t-leongchuan/r2auto_nav_CDE2310_grp4/docs/stl_files/Launcher Base.stl

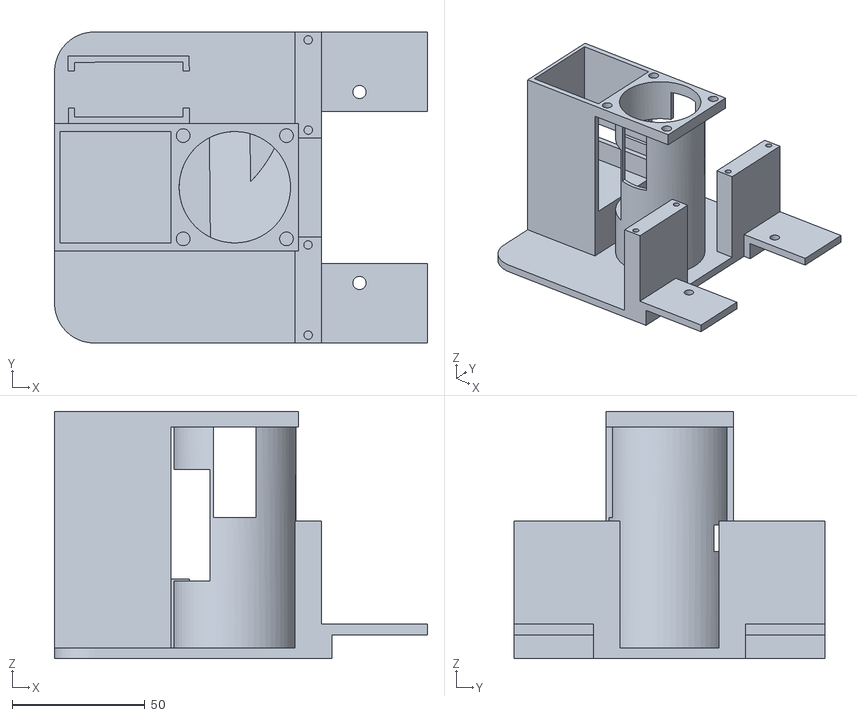
[picture p3: CAD file, 2025-04-23]
docs/stl_files/Launcher Base.stl
140.6 x 117.3 x 93.3
