t-leongchuan/r2auto_nav_CDE2310_grp4/docs/stl_files/Servo Adapter.stl

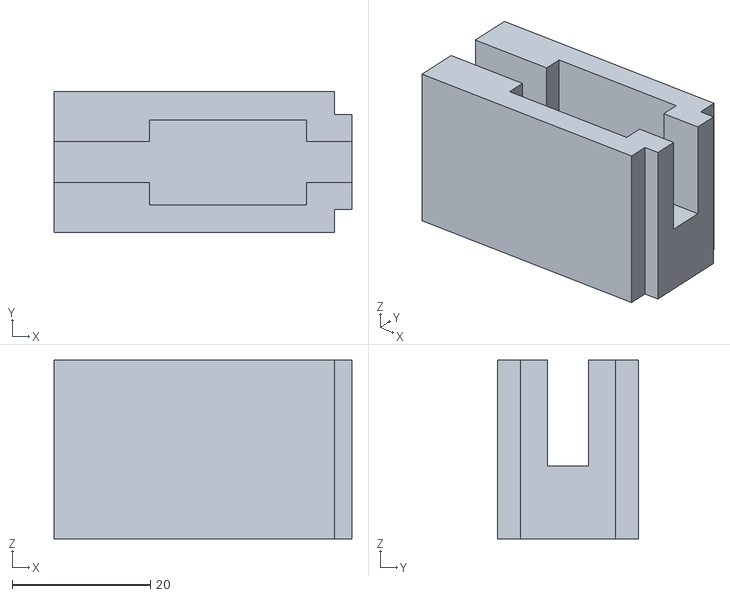
[picture p4: CAD file, 2025-04-23]
docs/stl_files/Servo Adapter.stl
43.1 x 20.4 x 25.9
