t-leongchuan/r2auto_nav_CDE2310_grp4/docs/stl_files/Motor Holder.stl

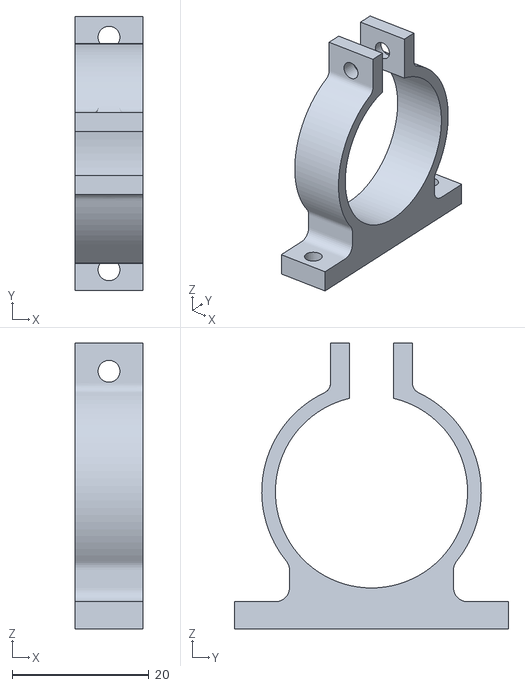
[picture p5: CAD file, 2025-04-23]
docs/stl_files/Motor Holder.stl
10.0 x 40.0 x 41.8
