t-leongchuan/r2auto_nav_CDE2310_grp4/docs/stl_files/AMG8833 Holder.stl

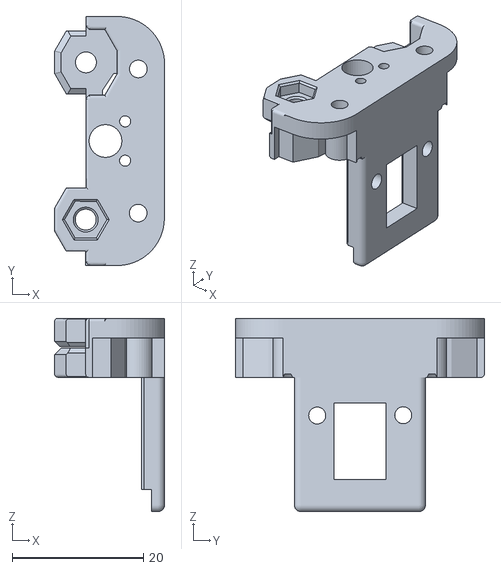
[picture p6: CAD file, 2025-04-23]
docs/stl_files/AMG8833 Holder.stl
16.8 x 38.0 x 29.5
