t-leongchuan/r2auto_nav_CDE2310_grp4/docs/stl_files/L298N Holder.stl

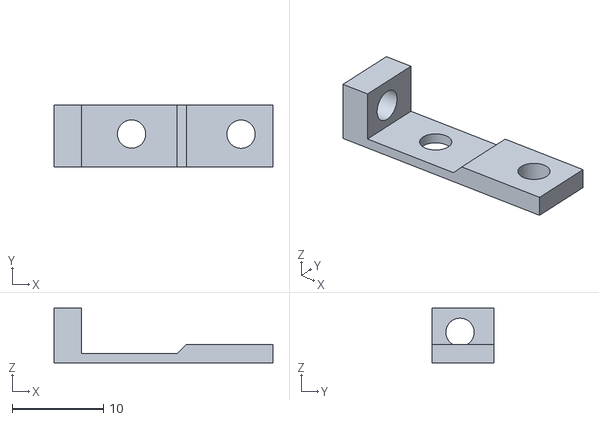
[picture p7: CAD file, 2025-04-23]
docs/stl_files/L298N Holder.stl
24.0 x 6.80 x 6.00
