t-leongchuan/r2auto_nav_CDE2310_grp4/docs/stl_files/Ball Feeder.stl

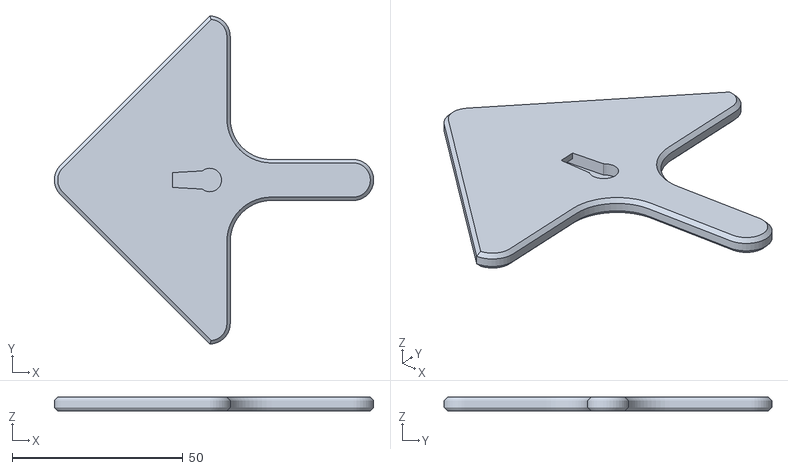
[picture p8: CAD file, 2025-04-23]
docs/stl_files/Ball Feeder.stl
93.5 x 96.0 x 4.00
