t-leongchuan/r2auto_nav_CDE2310_grp4/docs/stl_files/Modified Waffle Plate for LDS.stl

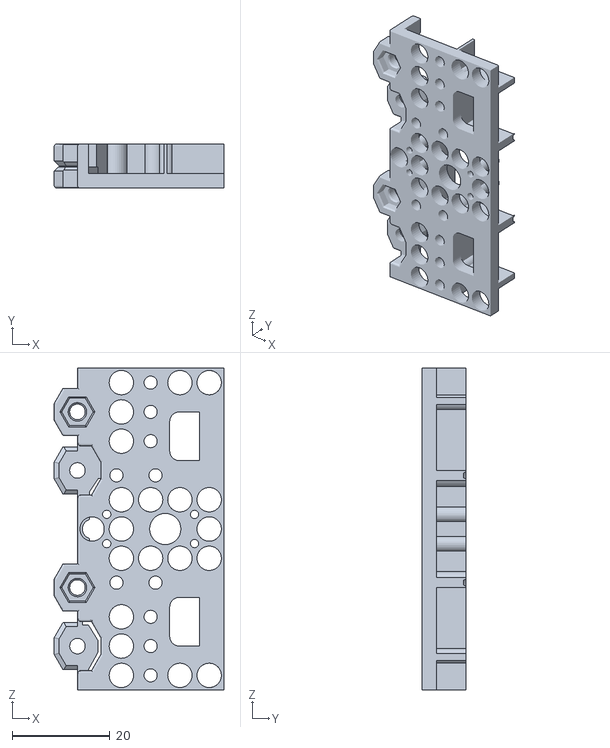
[picture p10: CAD file, 2025-04-23]
docs/stl_files/Modified Waffle Plate for LDS.stl
34.8 x 9.00 x 66.0
