t-leongchuan/r2auto_nav_CDE2310_grp4/docs/stl_files/Hopper (Launcher Top Half).stl

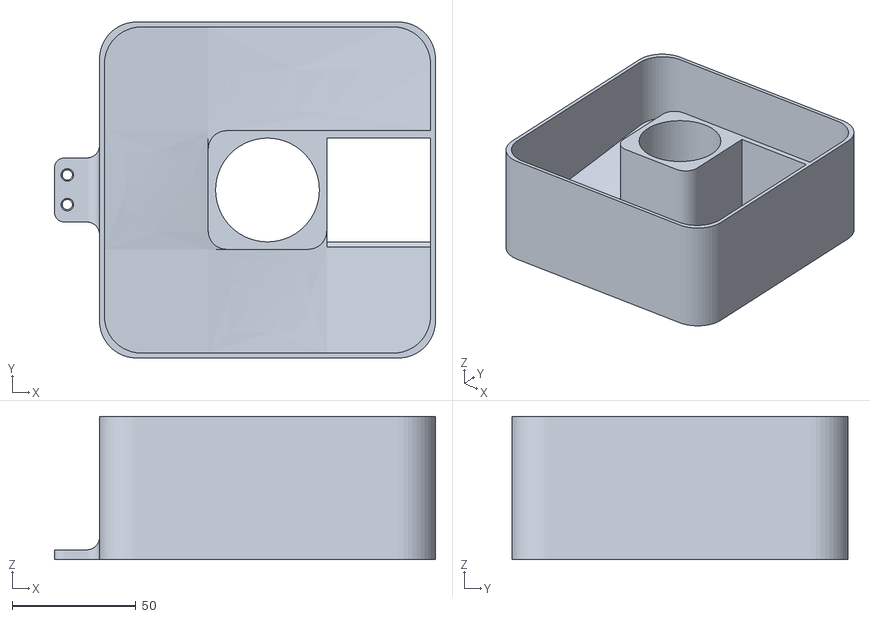
[picture p11: CAD file, 2025-04-23]
docs/stl_files/Hopper (Launcher Top Half).stl
154.2 x 136.0 x 58.0
