t-leongchuan/r2auto_nav_CDE2310_grp4/docs/stl_files/Fly Wheel.stl

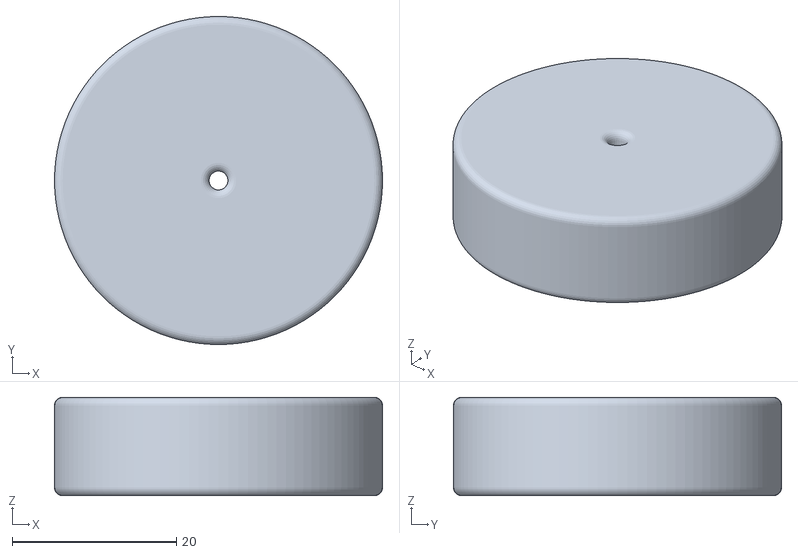
[picture p12: CAD file, 2025-04-23]
docs/stl_files/Fly Wheel.stl
40.0 x 40.0 x 12.0
