t-leongchuan/r2auto_nav_CDE2310_grp4/(commit log)

2025-03-27 add initial prototype
2025-03-29 add additional prototypes
2025-04-04 add more prototype files
2025-04-10 add more prototype code
2025-04-23 Instructions to fabricate & assemble our turtlebot
2025-04-23 Shuffle files to correct directories
    [AMG8833 Holder.stl, Ball Feeder.stl, Fly Wheel.stl, Hopper (Launcher Top Half).stl, L298N Holder.stl, Launcher Base.stl, Modified Waffle Plate for L298N.stl, Modified Waffle Plate for LDS.stl]
2025-04-23 Instructions to fabricate&assemble our turtlebot
2025-04-23 Fusion CAD File
